ThVerstappen/AI-Fx580VNX/GOI_LAP_6_LINH_KIEN_FX580_V8_USB_FIX1_2BO/BOM_FX580_V8_USB_FIX1_6PARTS.csv

Comment | Designator | Footprint | LCSCPart# | Manufacturer Part Number | Manufacturer | Quantity
FPC 24P 0.5mm | J4 | Connector_FFC-FPC:Hirose_FH12-24S-0.5SH_1x24-1MP_P0.50mm_Horizontal | C202112 | FH12-24S-0.5SH(55) | HRS(Hirose) | 1
0.47uH DFE252012F-R47M | L1 | FX580:DFE252012F | C703140 | DFE252012F-R47M=P2 | Murata Electronics | 1
47uH 20% rated 0.57A H1.5mm | L2 | FX580:L_TDK_BCL322515RT | C3220812 | BCL322515RT-470M-D | TDK | 1
Si1308EDL | Q3 | Package_TO_SOT_SMD:SOT-323_SC-70 | C469327 | SI1308EDL-T1-GE3 | Vishay Intertech | 1
BQ24074RGTR | U2 | FX580:BQ24074_V6 | C54313 | BQ24074RGTR | Texas Instruments | 1
TPS63802DLAR | U3 | FX580:VSON-10_L3.0-W2.0-P0.50-TL | C2845237 | TPS63802DLAR | Texas Instruments | 1
