ThVerstappen/AI-Fx580VNX/Hardware/FX580_Main_EPD_LAYOUT_V8/assembly/BOM_JLCPCB_V8_USB_FIX1.csv

Comment | Designator | Footprint | LCSCPart# | Manufacturer Part Number | Manufacturer | Quantity
1uF 50V 10% X5R | C1,C9 | Capacitor_SMD:C_0603_1608Metric | C15849 | CL10A105KB8NNNC | Samsung Electro-Mechanics | 2
10uF 10V 10% X5R | C2,C4 | Capacitor_SMD:C_0805_2012Metric | C5137471 | FCC0805X106K100FT | FOJAN | 2
4.7uF 16V 10% X5R | C3,C11 | Capacitor_SMD:C_0603_1608Metric | C19666 | CL10A475KO8NNNC | Samsung Electro-Mechanics | 2
22uF 10V 20% X5R | C5,C6,C7 | Capacitor_SMD:C_0805_2012Metric | C22367831 | HGC0805R5226M100NSLJ | Chinocera | 3
100nF 50V 10% X7R | C8,C10,C12,C13,C14,C25 | Capacitor_SMD:C_0603_1608Metric | C14663 | CC0603KRX7R9BB104 | YAGEO | 6
1uF 50V 10% X7R | C15,C17,C19,C20,C21,C22,C23,C24 | Capacitor_SMD:C_0603_1608Metric | C559769 | CC0603KRX7R9BB105 | YAGEO | 8
4.7uF 50V 10% X5R | C16,C18 | Capacitor_SMD:C_0805_2012Metric | C98192 | CL21A475KBQNNNE | Samsung Electro-Mechanics | 2
MBR0530T1G 30V 0.5A Vf<=0.43V@0.5A | D1,D2,D3 | Diode_SMD:D_SOD-123 | C82046 | MBR0530T1G | onsemi | 3
TYPE-C-31-M-12 | J1 | FX580:USB_C_Receptacle_HRO_TYPE-C-31-M-12 | C165948 | TYPE-C-31-M-12 | Korean Hroparts Elec | 1
Molex 104031-0811 | J3 | Connector_Card:microSD_HC_Molex_104031-0811 | C585350 | 1040310811 | MOLEX | 1
FPC 24P 0.5mm | J4 | Connector_FFC-FPC:Hirose_FH12-24S-0.5SH_1x24-1MP_P0.50mm_Horizontal | C202112 | FH12-24S-0.5SH(55) | HRS(Hirose) | 1
0.47uH DFE252012F-R47M | L1 | FX580:DFE252012F | C703140 | DFE252012F-R47M=P2 | Murata Electronics | 1
47uH 20% rated 0.57A H1.5mm | L2 | FX580:L_TDK_BCL322515RT | C3220812 | BCL322515RT-470M-D | TDK | 1
FS8205A | Q1 | FX580:SOT-23-6_L2.9-W1.6-P0.95-LS2.8-BR | C2830320 | FS8205A | TECH PUBLIC | 1
AO3401A | Q2 | Package_TO_SOT_SMD:SOT-23 | C15127 | AO3401A | Alpha & Omega Semicon | 1
Si1308EDL | Q3 | Package_TO_SOT_SMD:SOT-323_SC-70 | C469327 | SI1308EDL-T1-GE3 | Vishay Intertech | 1
5.1k 1% | R1,R2 | Resistor_SMD:R_0603_1608Metric | C23186 | 0603WAF5101T5E | UNI-ROYAL(Uniroyal Elec) | 2
22R 1% | R3,R4 | Resistor_SMD:R_0603_1608Metric | C23345 | 0603WAF220JT5E | UNI-ROYAL(Uniroyal Elec) | 2
3.0k 1% | R5 | Resistor_SMD:R_0603_1608Metric | C4211 | 0603WAF3001T5E | UNI-ROYAL(Uniroyal Elec) | 1
3.48k 1% | R6 | Resistor_SMD:R_0603_1608Metric | C22996 | 0603WAF3481T5E | UNI-ROYAL(Uniroyal Elec) | 1
511k 1% | R8 | Resistor_SMD:R_0603_1608Metric | C23194 | 0603WAF5113T5E | UNI-ROYAL(Uniroyal Elec) | 1
91k 1% | R9 | Resistor_SMD:R_0603_1608Metric | C23265 | 0603WAF9102T5E | UNI-ROYAL(Uniroyal Elec) | 1
100R 1% | R10 | Resistor_SMD:R_0603_1608Metric | C22775 | 0603WAF1000T5E | UNI-ROYAL(Uniroyal Elec) | 1
1k 1% | R11 | Resistor_SMD:R_0603_1608Metric | C21190 | 0603WAF1001T5E | UNI-ROYAL(Uniroyal Elec) | 1
10k 1% | R12,R13,R16,R17,R23,R24,R25,R26,R27 | Resistor_SMD:R_0603_1608Metric | C2906982 | FRC0603F1002TS | FOJAN | 9
4.7k 1% | R14,R15 | Resistor_SMD:R_0603_1608Metric | C23162 | 0603WAF4701T5E | UNI-ROYAL(Uniroyal Elec) | 2
100k 1% | R18,R19,R20,R28 | Resistor_SMD:R_0603_1608Metric | C25803 | 0603WAF1003T5E | UNI-ROYAL(Uniroyal Elec) | 4
1M 1% | R21,R22,R30 | Resistor_SMD:R_0603_1608Metric | C22935 | 0603WAF1004T5E | UNI-ROYAL(Uniroyal Elec) | 3
2.2R 1% | R29 | Resistor_SMD:R_0603_1608Metric | C22939 | 0603WAF220KT5E | UNI-ROYAL(Uniroyal Elec) | 1
ESP32-S3-MINI-1U-N4R2 | U1 | FX580:ESP32-S3-MINI-1U | C22356044 | ESP32-S3-MINI-1U-N4R2 | Espressif Systems | 1
BQ24074RGTR | U2 | FX580:BQ24074_V6 | C54313 | BQ24074RGTR | Texas Instruments | 1
TPS63802DLAR | U3 | FX580:VSON-10_L3.0-W2.0-P0.50-TL | C2845237 | TPS63802DLAR | Texas Instruments | 1
DW01A | U4 | Package_TO_SOT_SMD:SOT-23-6 | C351410 | DW01A | PUOLOP | 1
TCA8418RTWR | U5 | FX580:WQFN-24_L4.0-W4.0-P0.50-TL-EP2.5 | C138713 | TCA8418RTWR | Texas Instruments | 1
USBLC6-2SC6 | U6 | Package_TO_SOT_SMD:SOT-23-6 | C7519 | USBLC6-2SC6 | STMicroelectronics | 1
