ThVerstappen/AI-Fx580VNX/Hardware/FX580_Main_EPD_LAYOUT_V8/assembly/C25_PIN_MAPPING_V8_USB_FIX1.csv

Reference | MPN | Pad | Net | X_mm | Y_mm | Mid_X_mm | Mid_Y_mm | CAD_rotation_deg
C25 | CC0603KRX7R9BB104 | 1 | /VBUS | 56.6 | -53.025 | 56.6 | -53.8 | 270.0
C25 | CC0603KRX7R9BB104 | 2 | GND | 56.6 | -54.575 | 56.6 | -53.8 | 270.0
