ThVerstappen/AI-Fx580VNX/Hardware/FX580_Main_EPD_LAYOUT_V8/assembly/inherited_v7/EXCLUDED_AND_MANUAL_767bdf1a.csv

Reference | Value | Reason
J2 | RAW LiPo B+ B- / laced leads | PCB copper feature; no purchased component or machine placement
J5 | CELL NTC: TS / GND | PCB copper feature; no purchased component or machine placement
SW1 | ON | PCB copper feature; no purchased component or machine placement
SW2 | MENU | PCB copper feature; no purchased component or machine placement
SW3 | RIGHT | PCB copper feature; no purchased component or machine placement
SW4 | UP | PCB copper feature; no purchased component or machine placement
SW5 | ALPHA | PCB copper feature; no purchased component or machine placement
SW6 | SHIFT | PCB copper feature; no purchased component or machine placement
SW7 | INT | PCB copper feature; no purchased component or machine placement
SW8 | DOWN | PCB copper feature; no purchased component or machine placement
SW9 | LEFT | PCB copper feature; no purchased component or machine placement
SW10 | CALC | PCB copper feature; no purchased component or machine placement
SW11 | OPTN | PCB copper feature; no purchased component or machine placement
SW12 | LOG | PCB copper feature; no purchased component or machine placement
SW13 | POWn | PCB copper feature; no purchased component or machine placement
SW14 | POW2 | PCB copper feature; no purchased component or machine placement
SW15 | SQRT | PCB copper feature; no purchased component or machine placement
SW16 | FRAC | PCB copper feature; no purchased component or machine placement
SW17 | COS | PCB copper feature; no purchased component or machine placement
SW18 | SIN | PCB copper feature; no purchased component or machine placement
SW19 | POW-1 | PCB copper feature; no purchased component or machine placement
SW20 | DEG | PCB copper feature; no purchased component or machine placement
SW21 | MINUS | PCB copper feature; no purchased component or machine placement
SW22 | S-D | PCB copper feature; no purchased component or machine placement
SW23 | ) | PCB copper feature; no purchased component or machine placement
SW24 | ( | PCB copper feature; no purchased component or machine placement
SW25 | ENG | PCB copper feature; no purchased component or machine placement
SW26 | STO | PCB copper feature; no purchased component or machine placement
SW27 | AC | PCB copper feature; no purchased component or machine placement
SW28 | DEL | PCB copper feature; no purchased component or machine placement
SW29 | 9 | PCB copper feature; no purchased component or machine placement
SW30 | 8 | PCB copper feature; no purchased component or machine placement
SW31 | 7 | PCB copper feature; no purchased component or machine placement
SW32 | DIV | PCB copper feature; no purchased component or machine placement
SW33 | MUL | PCB copper feature; no purchased component or machine placement
SW34 | 6 | PCB copper feature; no purchased component or machine placement
SW35 | 5 | PCB copper feature; no purchased component or machine placement
SW36 | 4 | PCB copper feature; no purchased component or machine placement
SW37 | SUB | PCB copper feature; no purchased component or machine placement
SW38 | ADD | PCB copper feature; no purchased component or machine placement
SW39 | 3 | PCB copper feature; no purchased component or machine placement
SW40 | 2 | PCB copper feature; no purchased component or machine placement
SW41 | 1 | PCB copper feature; no purchased component or machine placement
SW42 | = | PCB copper feature; no purchased component or machine placement
SW43 | ANS | PCB copper feature; no purchased component or machine placement
SW44 | X10n | PCB copper feature; no purchased component or machine placement
SW45 | DOT | PCB copper feature; no purchased component or machine placement
SW46 | 0 | PCB copper feature; no purchased component or machine placement
SW47 | BOOT | PCB copper feature; no purchased component or machine placement
SW48 | X | PCB copper feature; no purchased component or machine placement
SW49 | LN | PCB copper feature; no purchased component or machine placement
SW50 | TAN | PCB copper feature; no purchased component or machine placement
SW51 | M+ | PCB copper feature; no purchased component or machine placement
TP1 | GND | PCB copper feature; no purchased component or machine placement
TP2 | 3V3 | PCB copper feature; no purchased component or machine placement
TP3 | SYS | PCB copper feature; no purchased component or machine placement
TP4 | BAT_P | PCB copper feature; no purchased component or machine placement
TP5 | EN | PCB copper feature; no purchased component or machine placement
TP6 | BOOT | PCB copper feature; no purchased component or machine placement
TP7 | UART_TX | PCB copper feature; no purchased component or machine placement
TP8 | UART_RX | PCB copper feature; no purchased component or machine placement
TH1 | 103AT-2 10k at 25C | External Semitec 103AT-2 NTC attached/insulated on battery; hand wired to J5; outside CPL
