ThVerstappen/AI-Fx580VNX/Hardware/FX580_Main_EPD_LAYOUT_V8/assembly/inherited_v7/DIODE_POLARITY_V7_BOOST2.png

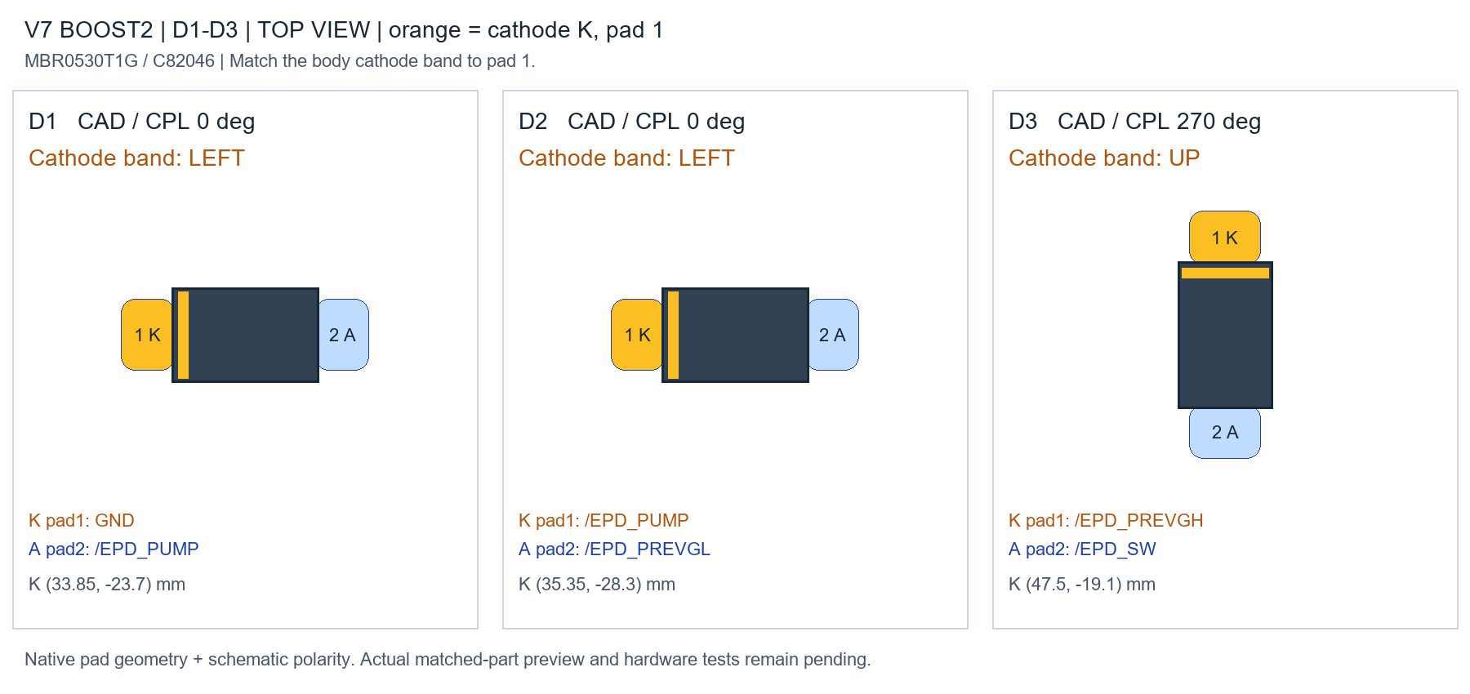
Hardware/FX580_Main_EPD_LAYOUT_V8/assembly/inherited_v7/DIODE_POLARITY_V7_BOOST2.png
