ThVerstappen/AI-Fx580VNX/HUONG_DAN_SETUP_MURATA_FX580_V8/assets/GUIDE_STENCIL_PREVIEW.png

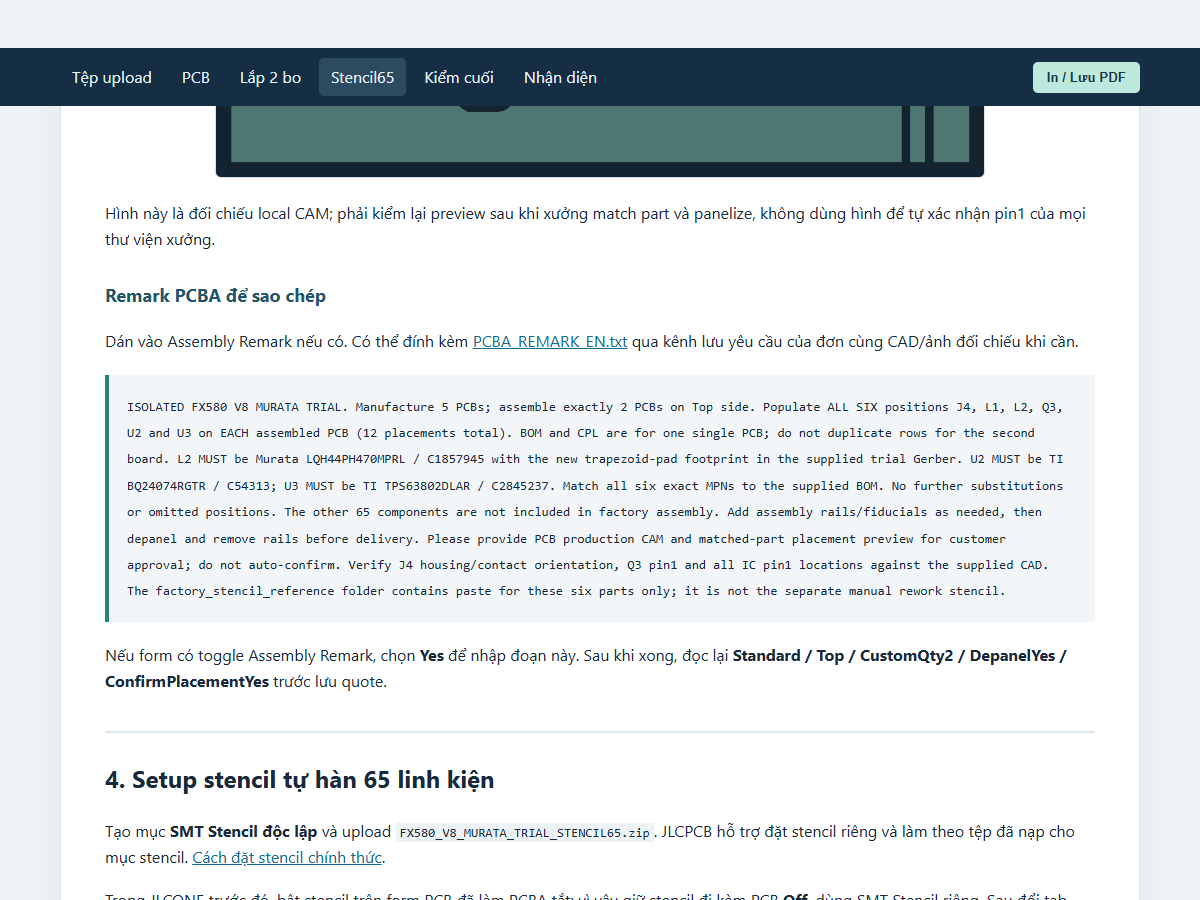
HUONG_DAN_SETUP_MURATA_FX580_V8/assets/GUIDE_STENCIL_PREVIEW.png
