ThVerstappen/AI-Fx580VNX/GOI_GERBER_FX580_V8_USB_FIX1_5PCB/CAM_keyface.png

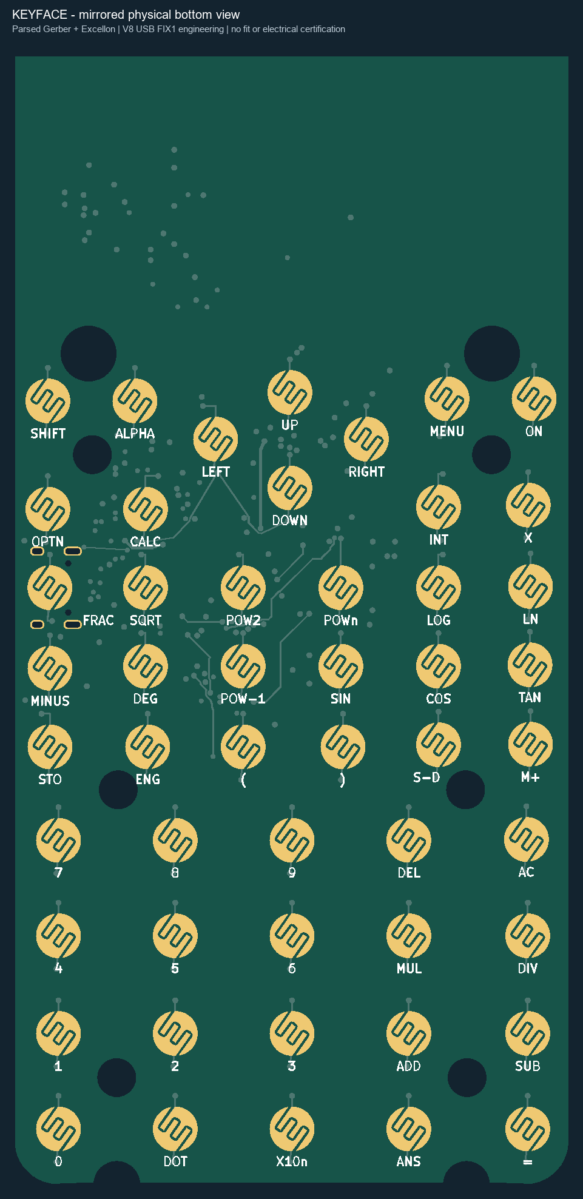
GOI_GERBER_FX580_V8_USB_FIX1_5PCB/CAM_keyface.png
