ThVerstappen/AI-Fx580VNX/Hardware/FX580_Main_EPD_LAYOUT_V8/USB_FIX1_REPORTS/CAM_USB_F_Cu.png

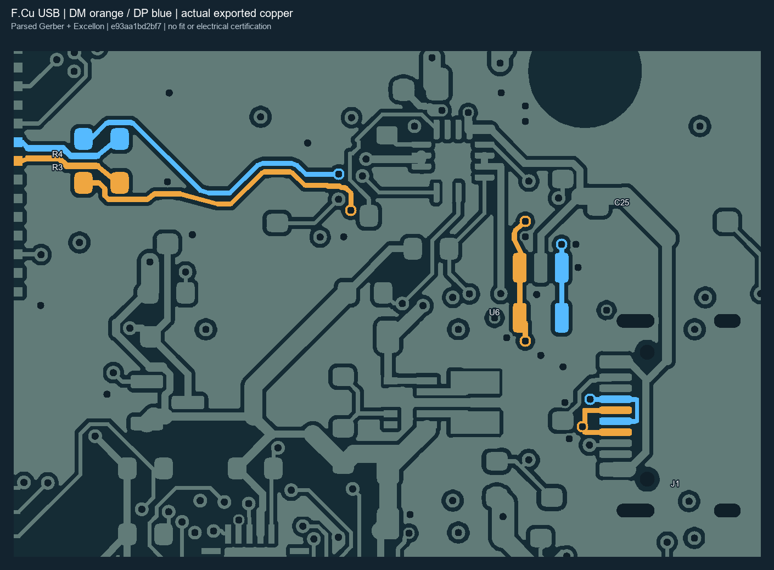
Hardware/FX580_Main_EPD_LAYOUT_V8/USB_FIX1_REPORTS/CAM_USB_F_Cu.png
