ThVerstappen/AI-Fx580VNX/Hardware/FX580_Main_EPD_LAYOUT_V8/USB_FIX1_REPORTS/RELEASE_USB_MCU_GND.png

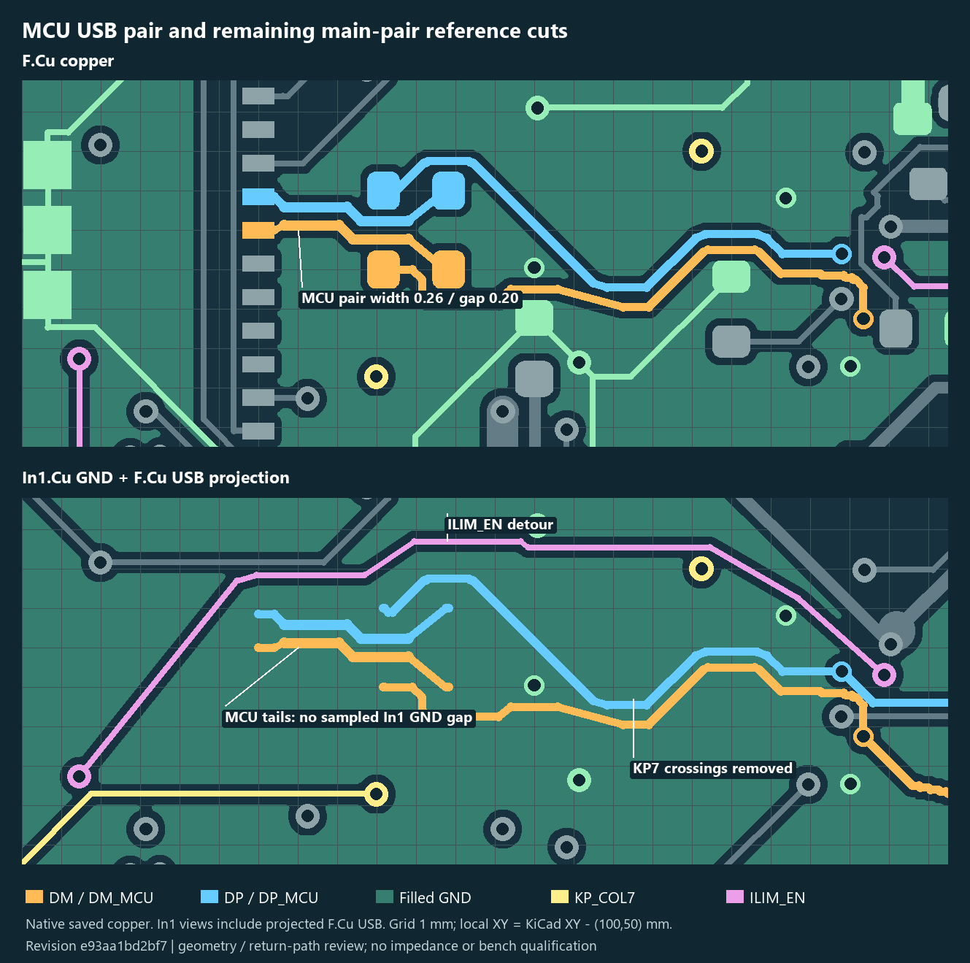
Hardware/FX580_Main_EPD_LAYOUT_V8/USB_FIX1_REPORTS/RELEASE_USB_MCU_GND.png
