ThVerstappen/AI-Fx580VNX/Hardware/FX580_Main_EPD_LAYOUT_V8/FX580_Main_EPD_LAYOUT_V8.kicad_pcb

## KiCad design Hardware/FX580_Main_EPD_LAYOUT_V8/FX580_Main_EPD_LAYOUT_V8.kicad_pcb (2026-10-16)

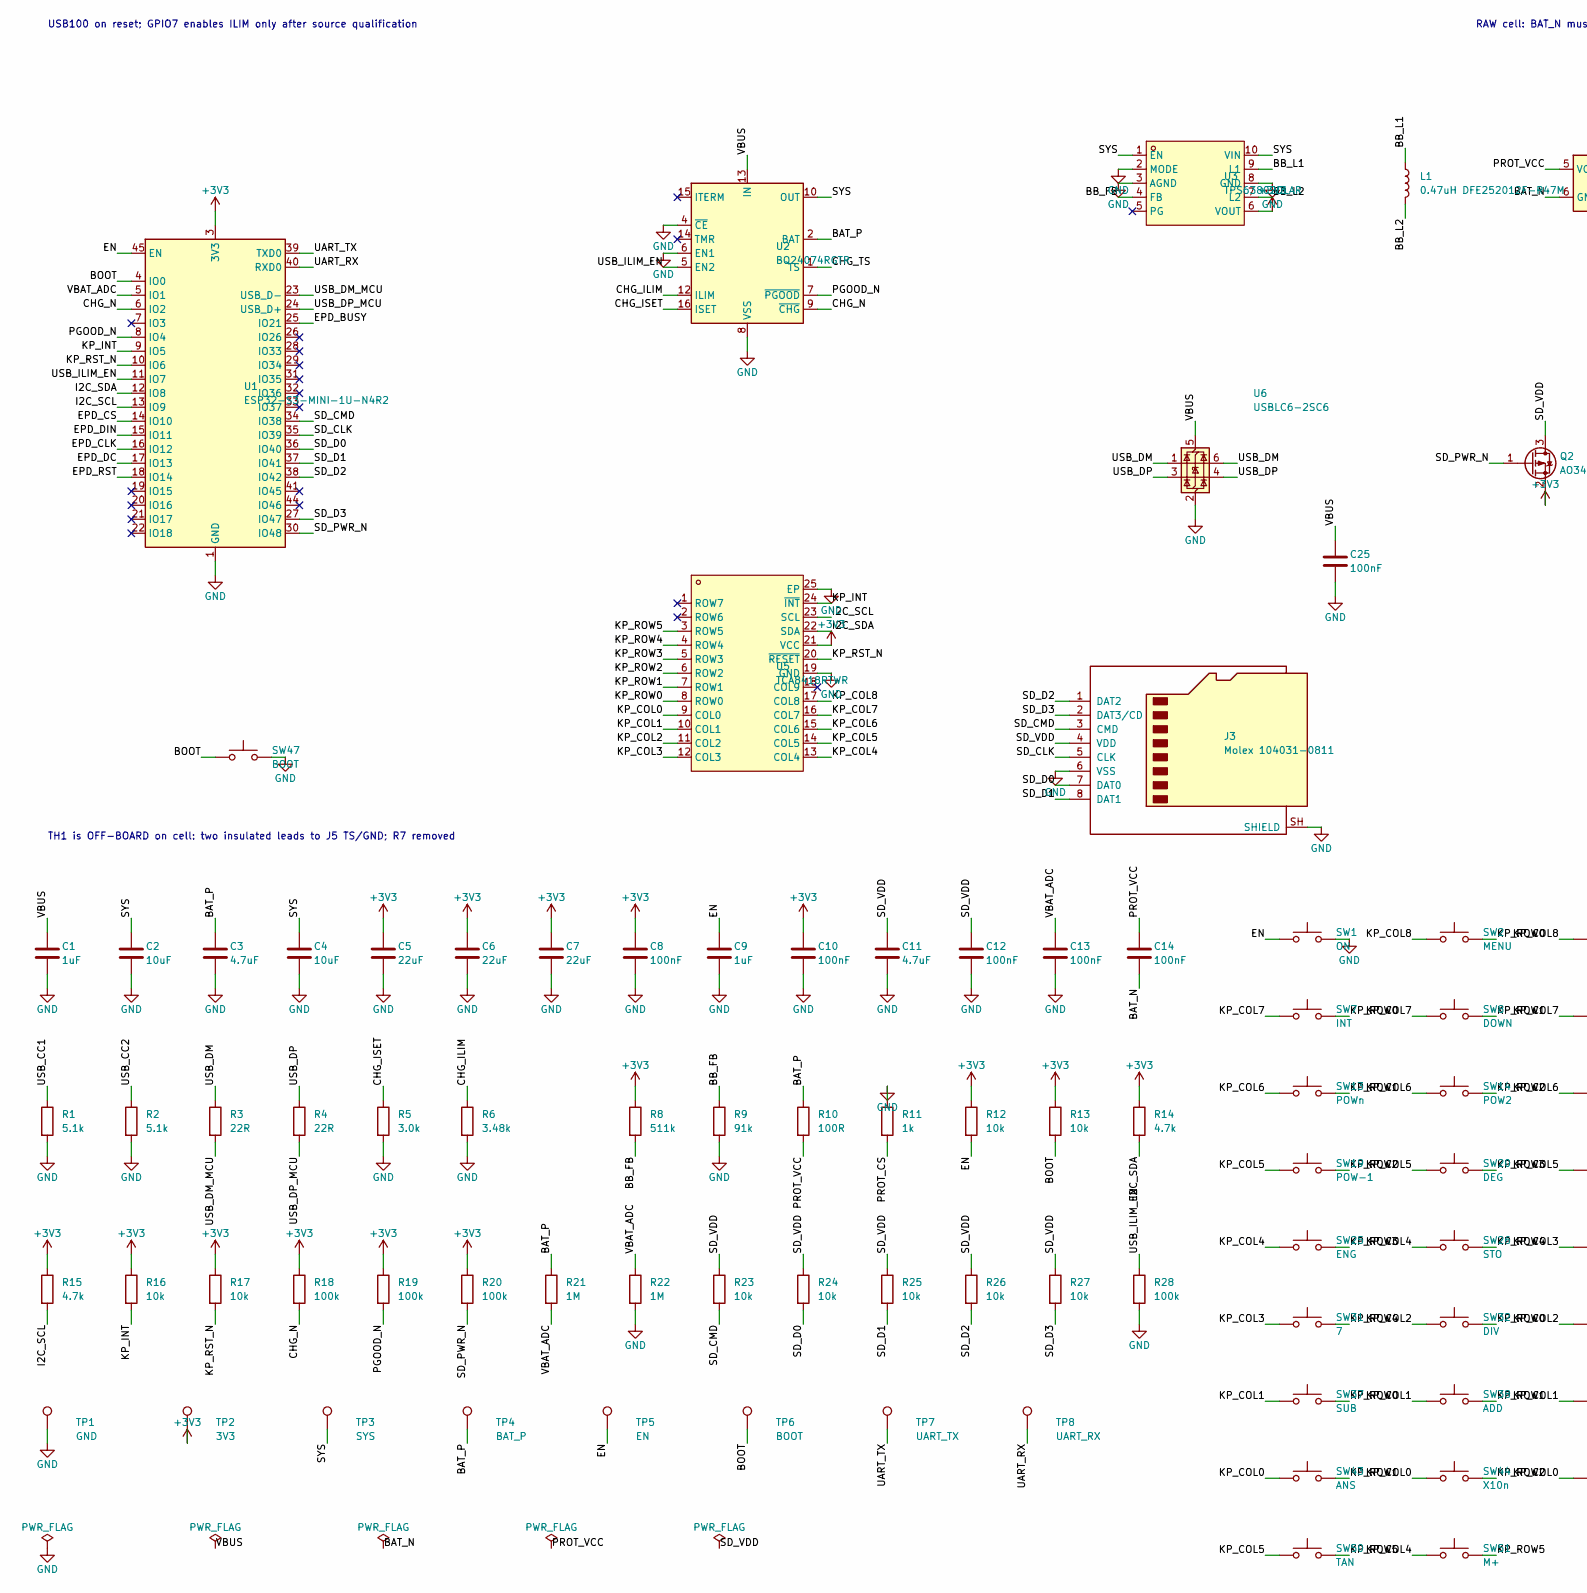
[picture p15: schematic FX580_Main_EPD_LAYOUT_V8.kicad_sch, FX580 V8 USB_FIX1 engineering DRAFT, part in row 1, column 1]

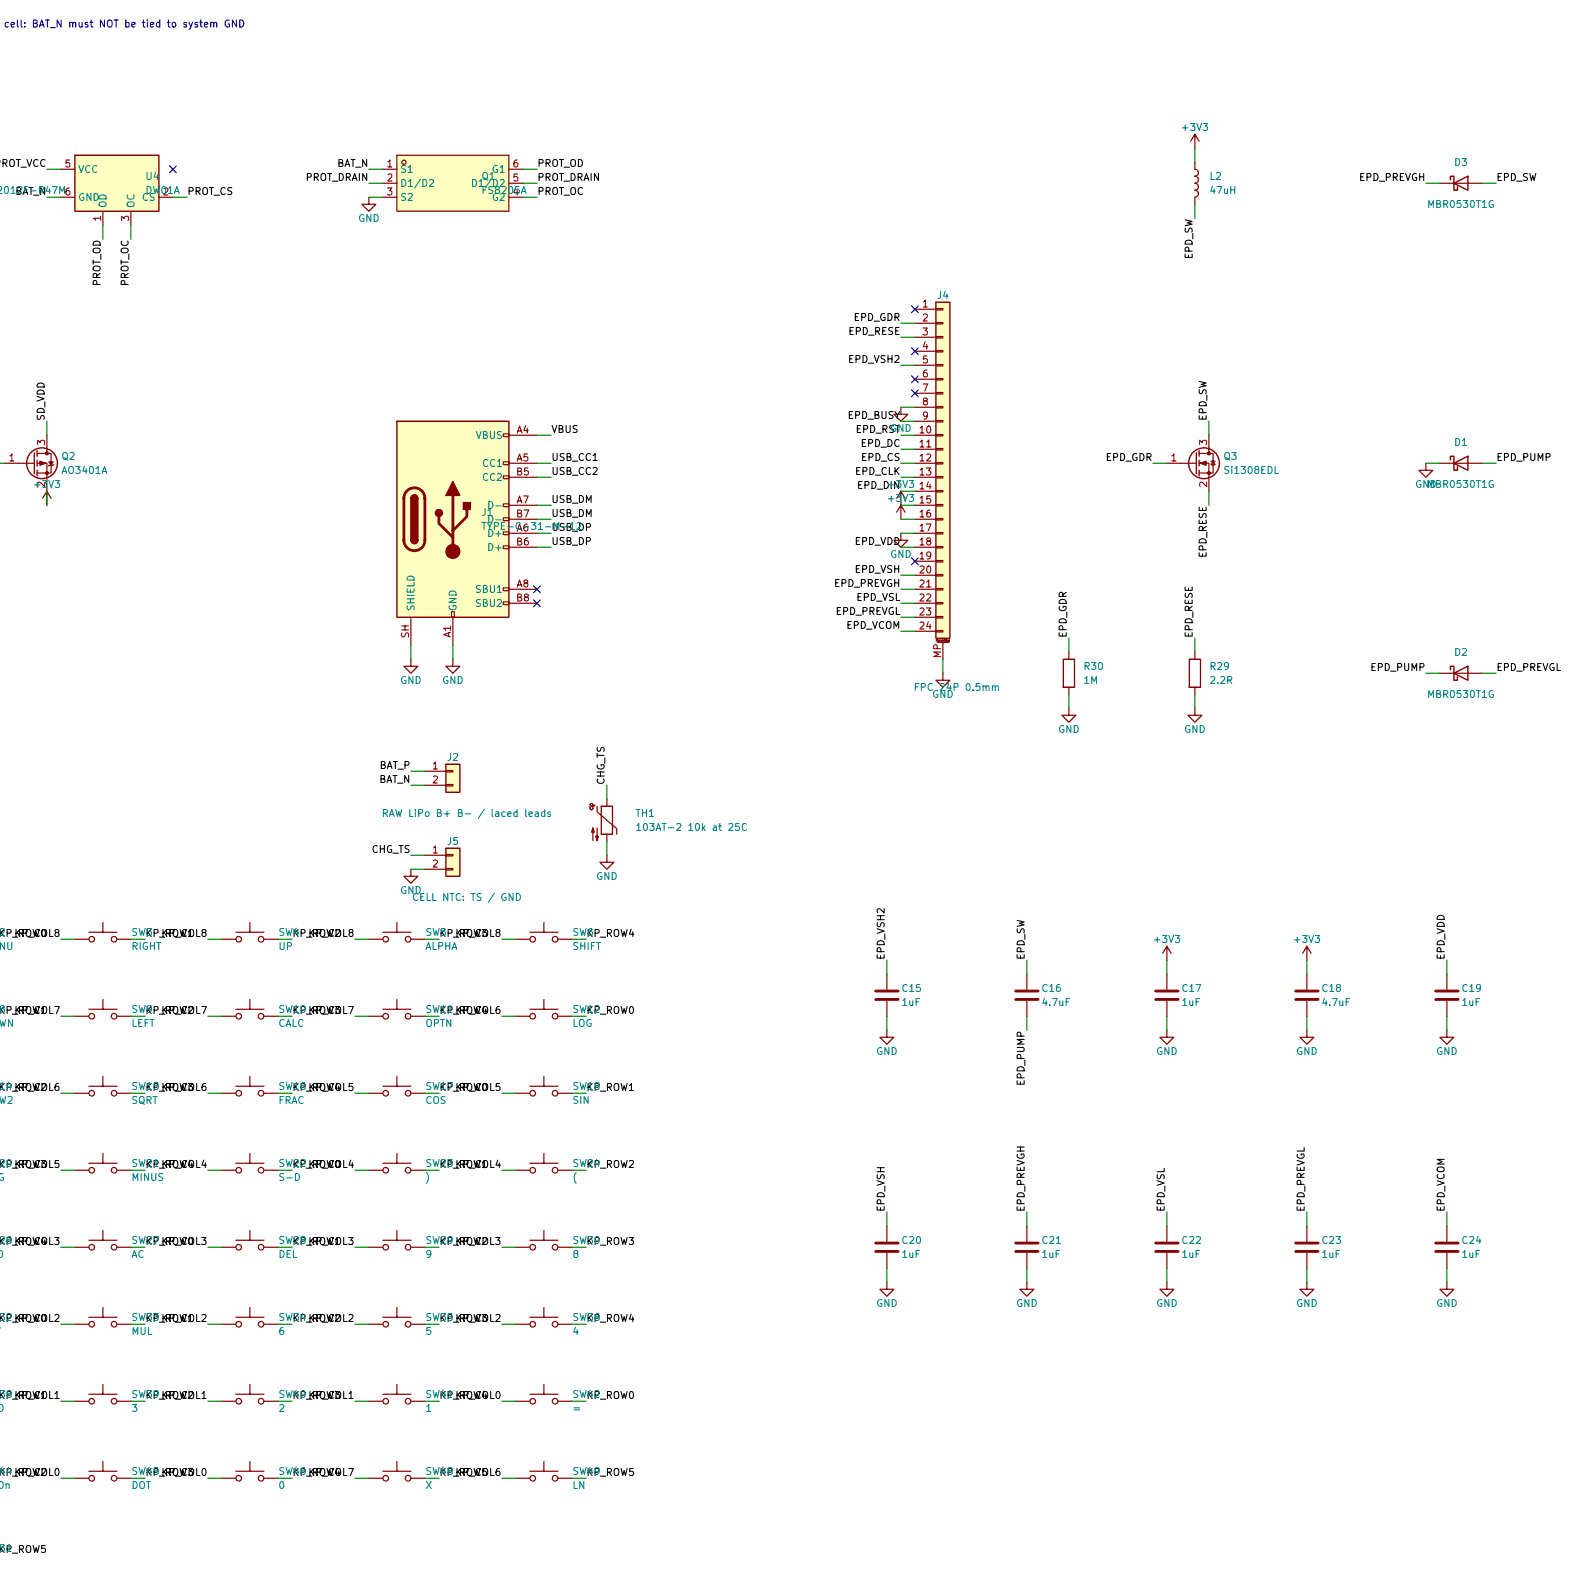
[picture p16: schematic FX580_Main_EPD_LAYOUT_V8.kicad_sch, FX580 V8 USB_FIX1 engineering DRAFT, part in row 1, column 2]

Parts:
C1, C9: 1uF; C_0603_1608Metric; Voltage 50V; LCSC C15849
C2, C4: 10uF; C_0805_2012Metric; Voltage 10V; LCSC C5137471
C3, C11: 4.7uF; C_0603_1608Metric; Voltage 16V; LCSC C19666
C5, C6, C7: 22uF; C_0805_2012Metric; Voltage 10V; LCSC C22367831
C8, C10, C12, C13, C14, C25: 100nF; C_0603_1608Metric; Voltage 50V; LCSC C14663
C15, C17, C19, C20, C21, C22, C23, C24: 1uF; C_0603_1608Metric; Voltage 50V
C16, C18: 4.7uF; C_0805_2012Metric; Voltage 50V
D1, D2, D3: MBR0530T1G; D_SOD-123; MPN MBR0530T1G; LCSC C82046
J1: TYPE-C-31-M-12; USB_C_Receptacle_HRO_TYPE-C-31-M-12; MPN TYPE-C-31-M-12
J2: RAW LiPo B+ B- / laced leads; Battery_Pads_Reinforced
J3: Molex 104031-0811; microSD_HC_Molex_104031-0811; LCSC C585350
J4: FPC 24P 0.5mm; Hirose_FH12-24S-0.5SH_1x24-1MP_P0.50mm_Horizontal; MPN FH12-24S-0.5SH(55)
J5: CELL NTC: TS / GND; Cell_NTC_Pads
L1: 0.47uH DFE252012F-R47M; DFE252012F; LCSC C703140
L2: 47uH; L_TDK_BCL322515RT; MPN BCL322515RT-470M-D; LCSC C3220812
Q1: FS8205A; SOT-23-6_L2.9-W1.6-P0.95-LS2.8-BR; LCSC C2830320
Q2: AO3401A; SOT-23; LCSC C15127
Q3: Si1308EDL; SOT-323_SC-70
R1, R2: 5.1k; R_0603_1608Metric; Tolerance 1%; LCSC C23186
R3, R4: 22R; R_0603_1608Metric; Tolerance 1%; LCSC C23345
R5: 3.0k; R_0603_1608Metric; Tolerance 1%; LCSC C4211
R6: 3.48k; R_0603_1608Metric; Tolerance 1%; LCSC C22996
R8: 511k; R_0603_1608Metric; Tolerance 1%; LCSC C23194
R9: 91k; R_0603_1608Metric; Tolerance 1%; LCSC C23265
R10: 100R; R_0603_1608Metric; Tolerance 1%; LCSC C22775
R11: 1k; R_0603_1608Metric; Tolerance 1%; LCSC C21190
R12, R13, R16, R17, R23, R24, R25, R26, R27: 10k; R_0603_1608Metric; Tolerance 1%; LCSC C2906982
R14, R15: 4.7k; R_0603_1608Metric; Tolerance 1%; LCSC C23162
R18, R19, R20, R28: 100k; R_0603_1608Metric; Tolerance 1%; LCSC C25803
R21, R22: 1M; R_0603_1608Metric; Tolerance 1%; LCSC C22935
R29: 2.2R; R_0603_1608Metric; Tolerance 1%
R30: 1M; R_0603_1608Metric
SW1: ON; Keypad_Interleaved_5p2
SW2: MENU; Keypad_Interleaved_5p2
SW3: RIGHT; Keypad_Interleaved_5p2
SW4: UP; Keypad_Interleaved_5p2
SW5: ALPHA; Keypad_Interleaved_5p2
SW6: SHIFT; Keypad_Interleaved_5p2
SW7: INT; Keypad_Interleaved_5p2
SW8: DOWN; Keypad_Interleaved_5p2
SW9: LEFT; Keypad_Interleaved_5p2
SW10: CALC; Keypad_Interleaved_5p2
SW11: OPTN; Keypad_Interleaved_5p2
SW12: LOG; Keypad_Interleaved_5p2
SW13: POWn; Keypad_Interleaved_5p2
SW14: POW2; Keypad_Interleaved_5p2
SW15: SQRT; Keypad_Interleaved_5p2
SW16: FRAC; Keypad_Interleaved_5p2
SW17: COS; Keypad_Interleaved_5p2
SW18: SIN; Keypad_Interleaved_5p2
SW19: POW-1; Keypad_Interleaved_5p2
SW20: DEG; Keypad_Interleaved_5p2
SW21: MINUS; Keypad_Interleaved_5p2
SW22: S-D; Keypad_Interleaved_5p2
SW23: ); Keypad_Interleaved_5p2
SW24: (; Keypad_Interleaved_5p2
SW25: ENG; Keypad_Interleaved_5p2
SW26: STO; Keypad_Interleaved_5p2
SW27: AC; Keypad_Interleaved_5p2
SW28: DEL; Keypad_Interleaved_5p2
SW29: 9; Keypad_Interleaved_5p2
SW30: 8; Keypad_Interleaved_5p2
SW31: 7; Keypad_Interleaved_5p2
SW32: DIV; Keypad_Interleaved_5p2
SW33: MUL; Keypad_Interleaved_5p2
SW34: 6; Keypad_Interleaved_5p2
SW35: 5; Keypad_Interleaved_5p2
SW36: 4; Keypad_Interleaved_5p2
SW37: SUB; Keypad_Interleaved_5p2
SW38: ADD; Keypad_Interleaved_5p2
SW39: 3; Keypad_Interleaved_5p2
SW40: 2; Keypad_Interleaved_5p2
SW41: 1; Keypad_Interleaved_5p2
SW42: =; Keypad_Interleaved_5p2
SW43: ANS; Keypad_Interleaved_5p2
SW44: X10n; Keypad_Interleaved_5p2
SW45: DOT; Keypad_Interleaved_5p2
SW46: 0; Keypad_Interleaved_5p2
SW47: BOOT; Boot_Pads
SW48: X; Keypad_Interleaved_5p2
SW49: LN; Keypad_Interleaved_5p2
SW50: TAN; Keypad_Interleaved_5p2
SW51: M+; Keypad_Interleaved_5p2
TH1: 103AT-2 10k at 25C
TP1: GND; TestPoint_Pad_D1.0mm
TP2: 3V3; TestPoint_Pad_D1.0mm
TP3: SYS; TestPoint_Pad_D1.0mm
TP4: BAT_P; TestPoint_Pad_D1.0mm
TP5: EN; TestPoint_Pad_D1.0mm
TP6: BOOT; TestPoint_Pad_D1.0mm
TP7: UART_TX; TestPoint_Pad_D1.0mm
TP8: UART_RX; TestPoint_Pad_D1.0mm
U1: ESP32-S3-MINI-1U-N4R2; ESP32-S3-MINI-1U; MPN ESP32-S3-MINI-1U-N4R2
U2: BQ24074RGTR; BQ24074_V6; LCSC C54313
U3: TPS63802DLAR; VSON-10_L3.0-W2.0-P0.50-TL; LCSC C2845237
U4: DW01A; SOT-23-6; LCSC C351410
U5: TCA8418RTWR; WQFN-24_L4.0-W4.0-P0.50-TL-EP2.5; LCSC C138713
U6: USBLC6-2SC6; SOT-23-6; LCSC C7519

Connections:
+3V3: C5.1, C6.1, C7.1, C8.1, C10.1, C17.1, C18.1, J4.15, J4.16, L2.1, Q2.2 (S), R8.1, R12.1, R13.1, R14.1, R15.1, R16.1, R17.1, R18.1, R19.1, R20.1, TP2.1, U1.3 (3V3), U3.6 (VOUT), U5.21 (VCC)
/BAT_N: C14.2, J2.2, Q1.1 (S1), U4.6 (GND)
/BAT_P: C3.1, J2.1, R10.1, R21.1, TP4.1, U2.2 (BAT), U2.3 (BAT)
/BB_FB: R8.2, R9.1, U3.4 (FB)
/BB_L1: L1.1, U3.9 (L1)
/BB_L2: L1.2, U3.7 (L2)
/BOOT: R13.2, SW47.1, TP6.1, U1.4 (IO0)
/CHG_ILIM: R6.1, U2.12 (ILIM)
/CHG_ISET: R5.1, U2.16 (ISET)
/CHG_N: R18.2, U1.6 (IO2), U2.9 (~CHG)
/CHG_TS: J5.1, TH1.1, U2.1 (TS)
/EN: C9.1, R12.2, SW1.1, TP5.1, U1.45 (EN)
/EPD_BUSY: J4.9, U1.25 (IO21)
/EPD_CLK: J4.13, U1.16 (IO12)
/EPD_CS: J4.12, U1.14 (IO10)
/EPD_DC: J4.11, U1.17 (IO13)
/EPD_DIN: J4.14, U1.15 (IO11)
/EPD_GDR: J4.2, Q3.1 (G), R30.1
/EPD_PREVGH: C21.1, D3.1 (K), J4.21
/EPD_PREVGL: C23.1, D2.2 (A), J4.23
/EPD_PUMP: C16.2, D1.2 (A), D2.1 (K)
/EPD_RESE: J4.3, Q3.2 (S), R29.1
/EPD_RST: J4.10, U1.18 (IO14)
/EPD_SW: C16.1, D3.2 (A), L2.2, Q3.3 (D)
/EPD_VCOM: C24.1, J4.24
/EPD_VDD: C19.1, J4.18
/EPD_VSH: C20.1, J4.20
/EPD_VSH2: C15.1, J4.5
/EPD_VSL: C22.1, J4.22
/I2C_SCL: R15.2, U1.13 (IO9), U5.23 (SCL)
/I2C_SDA: R14.2, U1.12 (IO8), U5.22 (SDA)
/KP_COL0: SW42.1, SW43.1, SW44.1, SW45.1, SW46.1, U5.9 (COL0)
/KP_COL1: SW37.1, SW38.1, SW39.1, SW40.1, SW41.1, U5.10 (COL1)
/KP_COL2: SW32.1, SW33.1, SW34.1, SW35.1, SW36.1, U5.11 (COL2)
/KP_COL3: SW27.1, SW28.1, SW29.1, SW30.1, SW31.1, U5.12 (COL3)
/KP_COL4: SW22.1, SW23.1, SW24.1, SW25.1, SW26.1, SW51.1, U5.13 (COL4)
/KP_COL5: SW17.1, SW18.1, SW19.1, SW20.1, SW21.1, SW50.1, U5.14 (COL5)
/KP_COL6: SW12.1, SW13.1, SW14.1, SW15.1, SW16.1, SW49.1, U5.15 (COL6)
/KP_COL7: SW7.1, SW8.1, SW9.1, SW10.1, SW11.1, SW48.1, U5.16 (COL7)
/KP_COL8: SW2.1, SW3.1, SW4.1, SW5.1, SW6.1, U5.17 (COL8)
/KP_INT: R16.2, U1.9 (IO5), U5.24 (~INT)
/KP_ROW0: SW2.2, SW7.2, SW12.2, SW17.2, SW22.2, SW27.2, SW32.2, SW37.2, SW42.2, U5.8 (ROW0)
/KP_ROW1: SW3.2, SW8.2, SW13.2, SW18.2, SW23.2, SW28.2, SW33.2, SW38.2, SW43.2, U5.7 (ROW1)
/KP_ROW2: SW4.2, SW9.2, SW14.2, SW19.2, SW24.2, SW29.2, SW34.2, SW39.2, SW44.2, U5.6 (ROW2)
/KP_ROW3: SW5.2, SW10.2, SW15.2, SW20.2, SW25.2, SW30.2, SW35.2, SW40.2, SW45.2, U5.5 (ROW3)
/KP_ROW4: SW6.2, SW11.2, SW16.2, SW21.2, SW26.2, SW31.2, SW36.2, SW41.2, SW46.2, U5.4 (ROW4)
/KP_ROW5: SW48.2, SW49.2, SW50.2, SW51.2, U5.3 (ROW5)
/KP_RST_N: R17.2, U1.10 (IO6), U5.20 (~RESET)
/PGOOD_N: R19.2, U1.8 (IO4), U2.7 (~PGOOD)
/PROT_CS: R11.2, U4.2 (CS)
/PROT_DRAIN: Q1.2 (D1/D2), Q1.5 (D1/D2)
/PROT_OC: Q1.4 (G2), U4.3 (OC)
/PROT_OD: Q1.6 (G1), U4.1 (OD)
/PROT_VCC: C14.1, R10.2, U4.5 (VCC)
/SD_CLK: J3.5 (CLK), U1.35 (IO39)
/SD_CMD: J3.3 (CMD), R23.2, U1.34 (IO38)
/SD_D0: J3.7 (DAT0), R24.2, U1.36 (IO40)
/SD_D1: J3.8 (DAT1), R25.2, U1.37 (IO41)
/SD_D2: J3.1 (DAT2), R26.2, U1.38 (IO42)
/SD_D3: J3.2 (DAT3/CD), R27.2, U1.27 (IO47)
/SD_PWR_N: Q2.1 (G), R20.2, U1.30 (IO48)
/SD_VDD: C11.1, C12.1, J3.4 (VDD), Q2.3 (D), R23.1, R24.1, R25.1, R26.1, R27.1
/SYS: C2.1, C4.1, TP3.1, U2.10 (OUT), U2.11 (OUT), U3.1 (EN), U3.10 (VIN)
/UART_RX: TP8.1, U1.40 (RXD0)
/UART_TX: TP7.1, U1.39 (TXD0)
/USB_CC1: J1.A5 (CC1), R1.1
/USB_CC2: J1.B5 (CC2), R2.1
/USB_DM: J1.A7 (D-), J1.B7 (D-), R3.1, U6.1 (I/O1), U6.6 (I/O1)
/USB_DM_MCU: R3.2, U1.23 (USB_D-)
/USB_DP: J1.A6 (D+), J1.B6 (D+), R4.1, U6.3 (I/O2), U6.4 (I/O2)
/USB_DP_MCU: R4.2, U1.24 (USB_D+)
/USB_ILIM_EN: R28.1, U1.11 (IO7), U2.5 (EN2)
/VBAT_ADC: C13.1, R21.2, R22.1, U1.5 (IO1)
/VBUS: C1.1, C25.1, J1.A4 (VBUS), J1.A9 (VBUS), J1.B4 (VBUS), J1.B9 (VBUS), U2.13 (IN), U6.5 (VBUS)
GND: C1.2, C2.2, C3.2, C4.2, C5.2, C6.2, C7.2, C8.2, C9.2, C10.2, C11.2, C12.2, C13.2, C15.2, C17.2, C18.2, C19.2, C20.2, C21.2, C22.2, C23.2, C24.2, C25.2, D1.1 (K), J1.A1 (GND), J1.A12 (GND), J1.B1 (GND), J1.B12 (GND), J1.SH (SHIELD), J3.6 (VSS), J3.SH (SHIELD), J4.8, J4.17, J4.MP (MountPin), J5.2, Q1.3 (S2), R1.2, R2.2, R5.2, R6.2, R9.2, R11.1, R22.2, R28.2, R29.2, R30.2, SW1.2, SW47.2, TH1.2, TP1.1, U1.1 (GND), U1.2 (GND), U1.42 (GND), U1.43 (GND), U1.46 (GND), U1.47 (GND), U1.48 (GND), U1.49 (GND), U1.50 (GND), U1.51 (GND), U1.52 (GND), U1.53 (GND), U1.54 (GND), U1.55 (GND), U1.56 (GND), U1.57 (GND), U1.58 (GND), U1.59 (GND), U1.60 (GND), U1.61 (GND), U1.62 (GND), U1.63 (GND), U1.64 (GND), U1.65 (GND), U2.4 (~CE), U2.6 (EN1), U2.8 (VSS), U2.17 (VSS), U3.2 (MODE), U3.3 (AGND), U3.8 (GND), U5.19 (GND), U5.25 (EP), U6.2 (GND)

Notes on the sheet:
USB100 on reset; GPIO7 enables ILIM only after source qualification
RAW cell: BAT_N must NOT be tied to system GND
TH1 is OFF-BOARD on cell: two insulated leads to J5 TS/GND; R7 removed

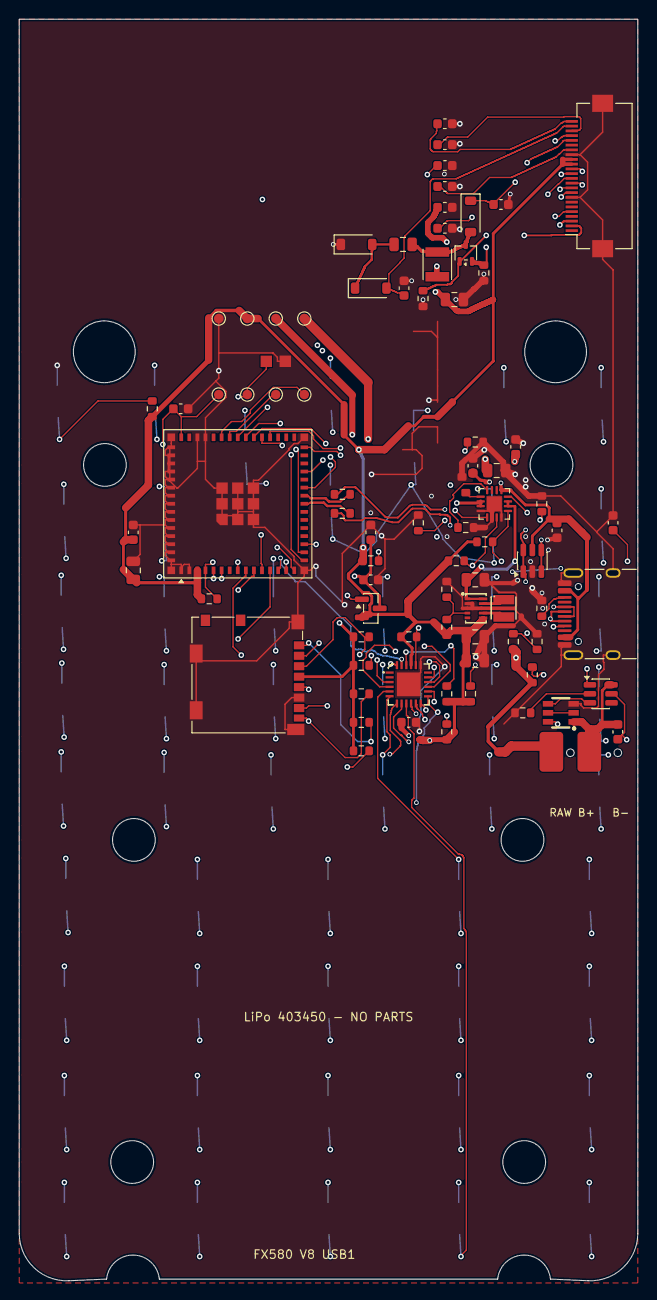
[picture p17: board FX580_Main_EPD_LAYOUT_V8.kicad_pcb from above]

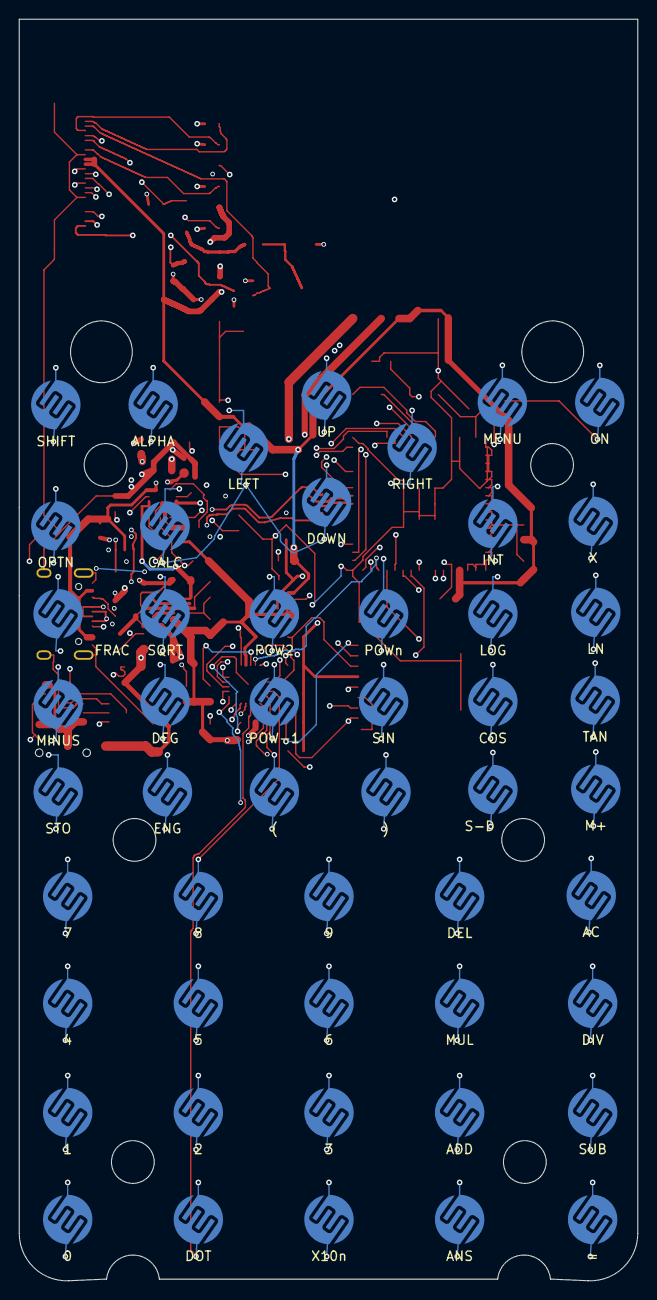
[picture p18: board FX580_Main_EPD_LAYOUT_V8.kicad_pcb from below]

Board: 4 copper layers, 65.1 x 132.8 mm, 132 parts (50 on the bottom side), 75 nets.
